Lena-Coppin/Le-Stylophuino/README.md

# Le-Variophuino
Un stylophone avec variation de fréquence...
...avec un soupçon de "frenchtouch"...
