Lena-Coppin/Le-Stylophuino/COPPIN_NOEL_G4_PeiP2_Arduino_projet_-_Variophuino.pptx

## Variophuino

Instrument de musique électronique basé sur le stylophone

COPPIN Léna NOEL Julien PeiP 2 G4

## Slide 2

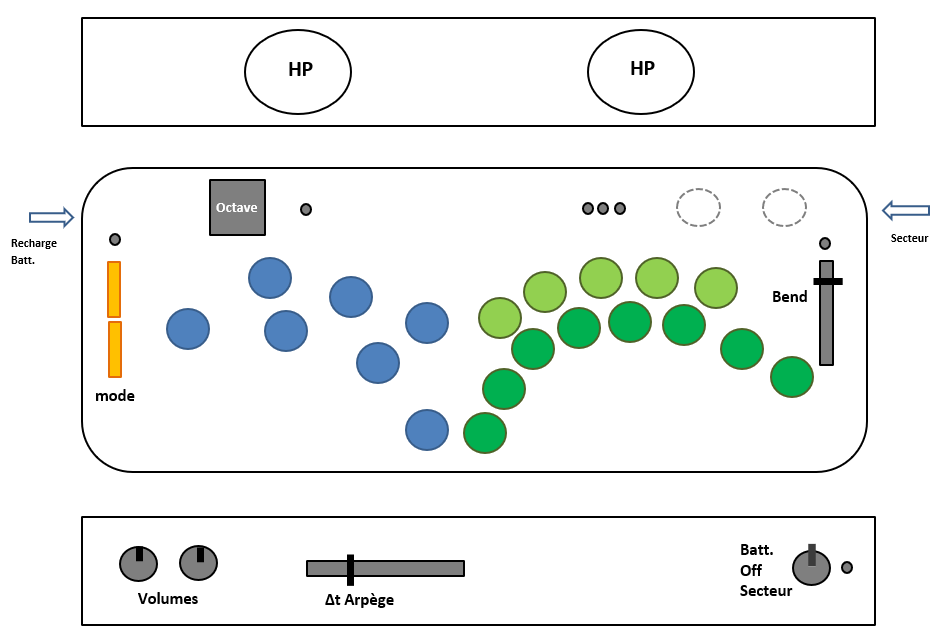
[picture p82: figure]

## Slide 3

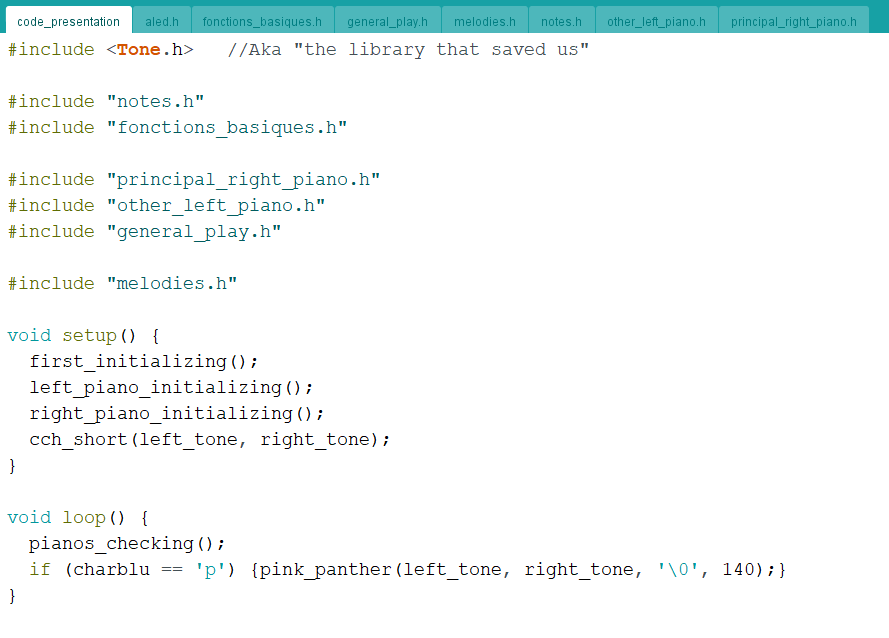
[picture p83: figure]

## Slide 4

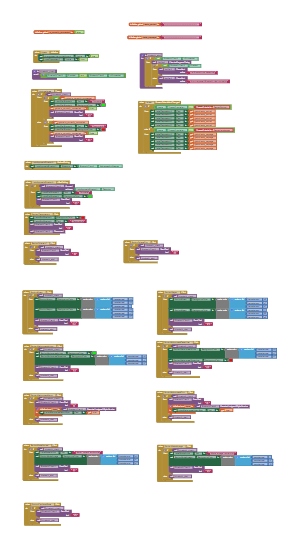
[picture p84: figure]
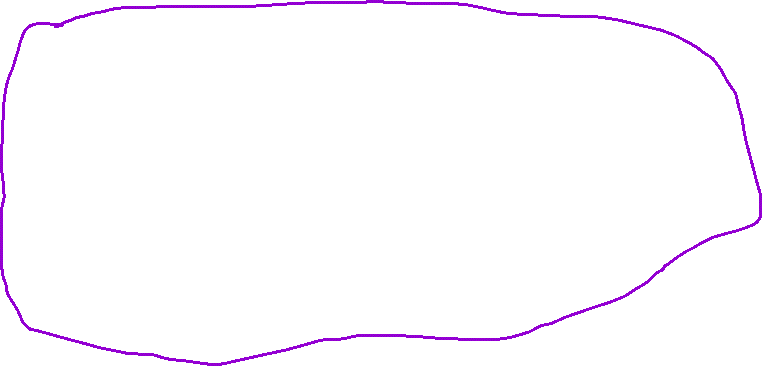
[picture p85: figure]
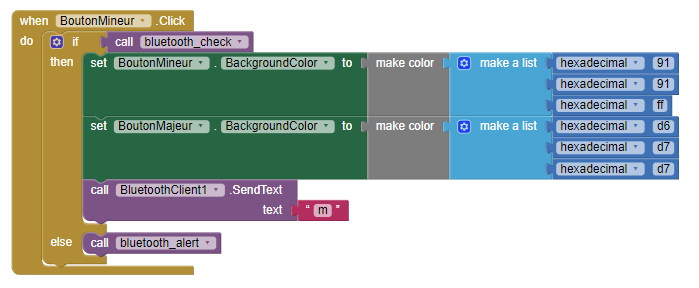
[picture p86: figure]

## Slide 5

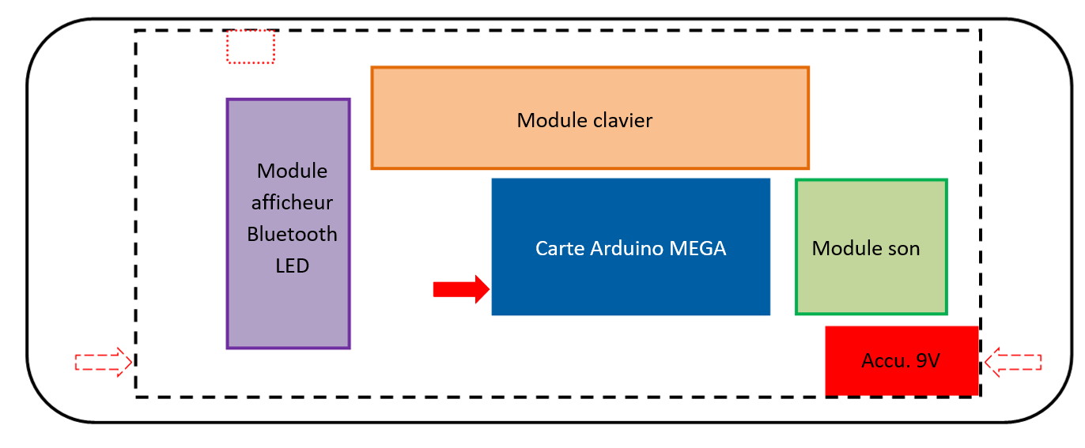
[picture p87: figure]

## Slide 6

Diagramme de Gantt final
