Lena-Coppin/Le-Stylophuino/Rapports de séances/Rapports Julien NOEL/Rapport de séance n°3 03-01-22.pdf

Julien NOEL | PeiP2 G4

Compte rendu séance 3 :

Il y a eu une grosse mise à jour du projet !

Tout d’abord voici la nouvelle organisation des fichiers :

code_fred_testons.ino est le fichier principal, où tous les fichiers .h seront importer (petite référence à Fred Testo pour le nom d’ailleurs, nom qui n’a pas d’importance car l’essentiel du code n’est pas dans ce fichier).

effets_bluetooth.h regroupera tous les effets que l’on pourra appliquer aux notes du piano principal droite.

En effet, maintenant le projet contient deux pianos indépendants (un « principal droite » et un autre « secondaire gauche ») avec un buzzer pour chaque. Par ailleurs, l’indépendance des deux buzzers a été un problème fort contraignant, problème réglé grâce à l’importation de la bibliothèque ToneLibrary.

Toutes les touches sont maintenant chacune reliées à une entrée numérique d’une carte Arduino MEGA.

Je pense que les noms des fichiers .h sont assez explicites par rapport à leur utilité principal, je ne détaillerai donc pas plus que les captures d’écran suivantes :

fonctions_basiques.h :

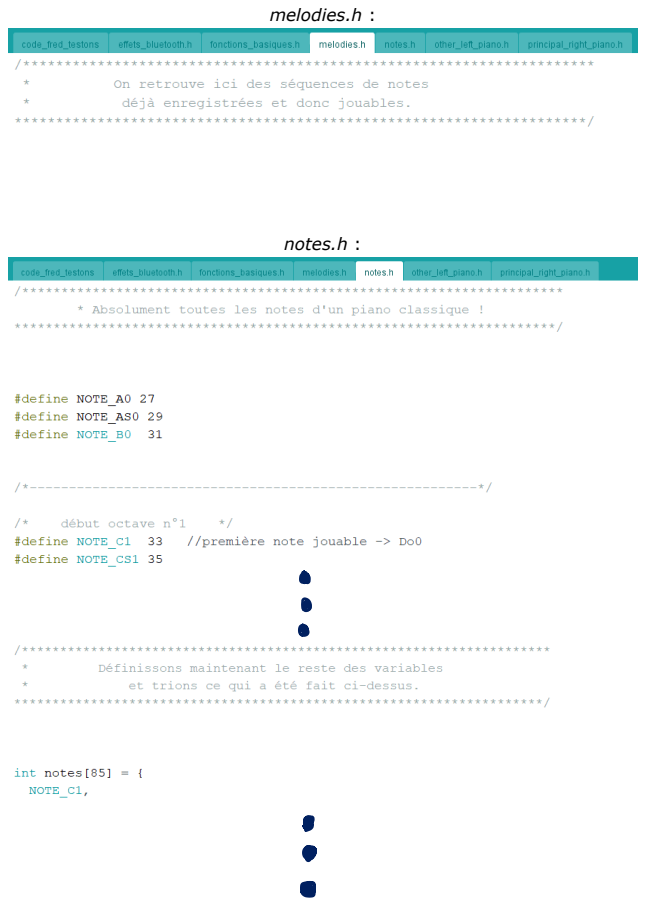
[picture p93: page 2]
melodies.h :; notes.h :

other_left_piano.h :

principal_right_piano.h :

Voici le code de code_fred_testons.ino au passage :

#include <Tone.h> //Aka "the library that saved us"

#include "notes.h"

#include "fonctions_basiques.h"

#include "principal_right_piano.h" #include "other_left_piano.h"

#include "melodies.h"

void setup() {
first_initializing();
left_piano_initializing(); right_piano_initializing(); cch_short(left_tone);
}

void loop() {
commands(Serial.read());
actual_frequencies_update(); left_piano_checking();
//right_piano_checking();
}

cch_short() est la fonction permettant de faire quelques sons quand la carte Arduino démarre.

left_piano_checking() et right_piano_checking() ne sont pas faites pour fonctionner simultanément, une fonction sera créée ultérieurement pour cela.

effets_bluetooth.h est importé dans fonctions_basiques.h (car pratique).
