Lena-Coppin/Le-Stylophuino/schemiano.pdf

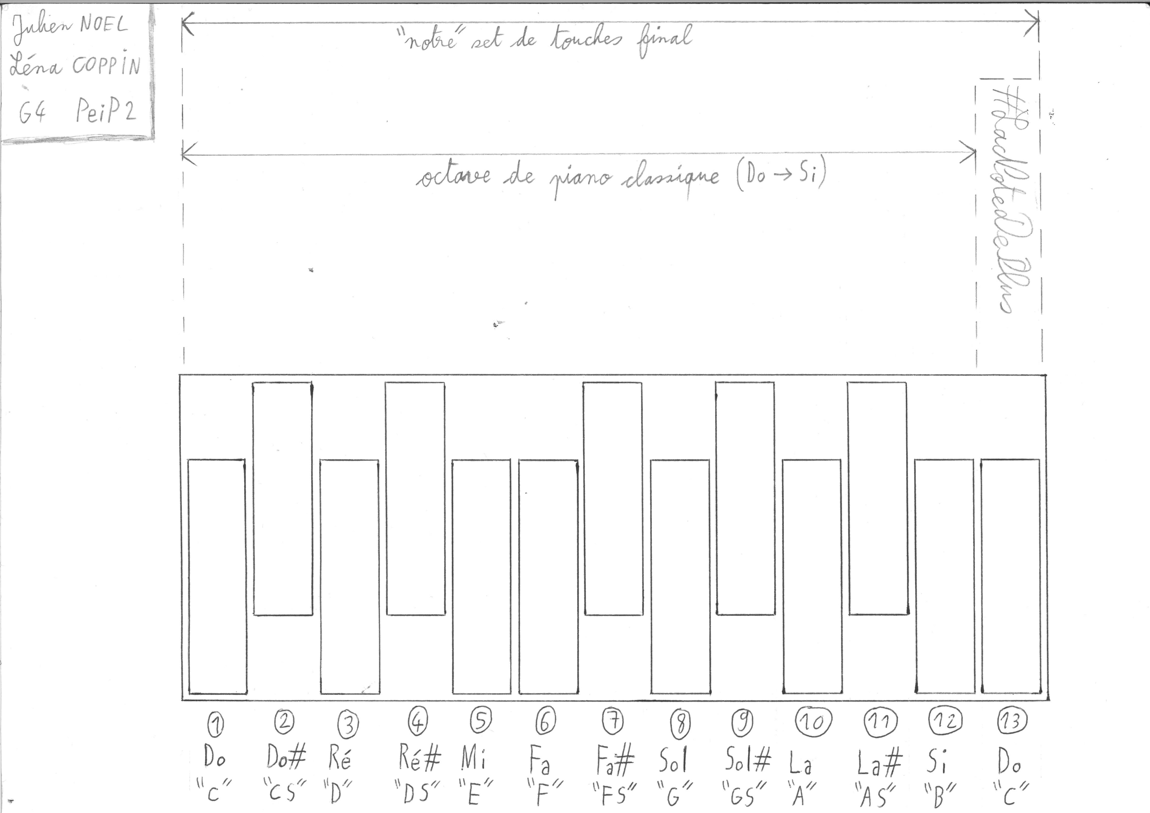
[picture p97: page 1]

yb- Noçt
f-û*" oo PP iN

t\ ,"t )"

erlr^* À* y* ttr-,"1'*

(r+ PeiP L

V
\
(1, -+ s;)

ç
fJ

gr'

@
Do#
"c s"

a
D,
//
C

5;
\\B//

5,1

,,
G,,

Ra
\t | trùr,

@@
R'#- Mi ttDs" "E"

@
5,1# La La#
"Gs" uA'
"As"

@
Ft

o
tr#
"F s'

Do

8

\\
F
/7 | t\
C

/7
