Lena-Coppin/Le-Stylophuino/Rapports de séances/Rapports Léna COPPIN/Programmes associés/piano_pot_2_notes_frequence_variation_2412_valide_8NOTES_OK_ALT.ino

//COPPIN Léna G4 PeiP2
//Programme permettant d'émettre un son avec un buzzer lors de l'appui d'une "touche" (appelée "bouton" ici) 
//Un potentiomètre lit et module la tension analogique envoyée aux I/O et en focntion de celle-ci on module la fréquence sortant du buzzer  = effet "pitchbend"
//Programme uniquement sur les notes naturelles, possibilité de jouer les notes altérées avec l'appuie d'un bouton (but_alt) 


//Déclaration des pins 
int but1 = 2;      //DO3
int but3 = 3;      //RE3
int but5 = 4;      //MI3
int but6 = 5;      //FA3
int but8 = 6;     //SOL3
int but10 = 7;    //LA3
int but12 = 8;     //SI3
int but13 = 9;     //DO4

int but_alt = 10;   //NOTE + 1/2 ton
//int but_oct = 11;  //NOTE A L'OCTAVE

int buzzer = 13;


//Initialisation des variables
const int pot = 0;
int bit_value = 0.0; //tension numérique
float real_tension = 0.0; //tension analogique

int f = 0; //fréquence 

void setup()
{
  //Déclarations des pins des "boutons" en INPUT
  pinMode(but1, INPUT);
  pinMode(but3, INPUT);
  pinMode(but5, INPUT);
  pinMode(but6, INPUT);
  pinMode(but8, INPUT);
  pinMode(but10, INPUT);
  pinMode(but12, INPUT);
  pinMode(but13, INPUT);
  
  pinMode(but_alt, INPUT);
  pinMode(but_oct, INPUT);

  //Déclarations des pins du buzzer en OUTPUT
  pinMode(buzzer, OUTPUT);

  //Communication voie série
  Serial.begin(9600);
}


void loop()
{
  //Lecture des valeurs des "boutons" (0 ou 1)
  int b1 = digitalRead(but1);
  int b3 = digitalRead(but3);
  int b5 = digitalRead(but5);
  int b6 = digitalRead(but6);
  int b8 = digitalRead(but8);
  int b10 = digitalRead(but10);
  int b12 = digitalRead(but12);
  int b13 = digitalRead(but13);
  
  int b_alt = digitalRead(but_alt);
  int b_oct = digitalRead(but_oct);
  
  
  //Lecture de la tension et affichage
  bit_value = analogRead(pot);
  real_tension = bit_value / 204.6;
  //Serial.print(real_tension);
  //Serial.print("  ");

//b_alt=1
if (b_alt == 1){
  //b1=1
  if( b1 == 1 ) {
    int f = 277;
  
    if(real_tension < 0.35){
      tone(buzzer, f);
      Serial.println("DO#3 : 277 Hz");
      }
  
    if((real_tension >= 0.35) && (real_tension < 0.8)){
      tone(buzzer, f+4);
      Serial.println("Modulation : 281 Hz");
      }
  
    if((real_tension >= 0.8) && (real_tension < 3)){
      tone(buzzer, f+8);
      Serial.println("Modulation : 285 Hz");
      }
        
    if((real_tension >= 3) && (real_tension < 4.8)){
      tone(buzzer, f+12);
      Serial.println("Modulation : 289 Hz");
      }
  
    if((real_tension >= 4.8) && (real_tension <= 5)){
      tone(buzzer, f+17);
      Serial.println("RE3 : 294 Hz");
      } 
    }





//b1=0
  if (b1==0) {
    
    //b3=0
    if (b3 == 0){
      
      //b5=0
      if (b5 == 0){
  
        //b6=0
        if (b6 == 0){
          
          //b8=0
          if (b8 == 0){
            
            //b10=0
            if (b10 == 0){
              
              //b12=0
              if (b12 == 0){
                
                //b13=0
                if (b13 == 0){
                  noTone(buzzer);
              }
                 //b13=1
                 if (b13 == 1){
                  
                  int f = 554;
                  
                  if(real_tension < 0.35){
                    tone(buzzer, f);
                    Serial.println("DO#4 : 554 Hz");
                    }
                
                  if((real_tension >= 0.35) && (real_tension < 0.8)){
                    tone(buzzer, f+8);
                    Serial.println("Modulation : 562 Hz");
                    }
                
                  if((real_tension >= 0.8) && (real_tension < 3)){
                    tone(buzzer, f+16);
                    Serial.println("Modulation : 570 Hz");
                    }
                      
                  if((real_tension >= 3) && (real_tension < 4.8)){
                    tone(buzzer, f+24);
                    Serial.println("Modulation : 578 Hz");
                    }
                
                  if((real_tension >= 4.8) && (real_tension <= 5)){
                    tone(buzzer, f+33);
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
          }
      
        if((real_tension >= 0.35) && (real_tension < 0.8)){
          tone(buzzer, f+5);
          Serial.println("Modulation : 354 Hz");
          }
      
        if((real_tension >= 0.8) && (real_tension < 3)){
          tone(buzzer, f+10);
          Serial.println("Modulation : 359 Hz");
          }
            
        if((real_tension >= 3) && (real_tension < 4.8)){
          tone(buzzer, f+15);
          Serial.println("Modulation : 364 Hz");
          }
      
        if((real_tension >= 4.8) && (real_tension <= 5)){
          tone(buzzer, f+21);
          Serial.println("FA#3 : 370 Hz");
          } 
       }
        
  //b3=1
  if ( b3 == 1 ){
    int f = 311;
  
    if(real_tension < 0.35){
      tone(buzzer, f);
      Serial.println("RE#3 : 311 Hz");
      }
  
    if((real_tension >= 0.35) && (real_tension < 0.8)){
      tone(buzzer, f+5);
      Serial.println("Modulation : 316 Hz");
      }
  
    if((real_tension >= 0.8) && (real_tension < 3)){
      tone(buzzer, f+10);
      Serial.println("Modulation : 321 Hz");
      }
        
    if((real_tension >= 3) && (real_tension < 4.8)){
      tone(buzzer, f+15);
      Serial.println("Modulation : 326 Hz");
      }
  
    if((real_tension >= 4.8) && (real_tension <= 5)){
      tone(buzzer, f+19);
      Serial.println("MI3 : 330 Hz");
      }
       }
  
}


//////////////////////////////////////////////////////////////////////////////////////////////////////////////////////////////////////////////////////////////////////////////////////////////////////////////////////////////////////


//b_alt=0
if(b_alt == 0){
  //b1=1
  if( b1 == 1 ) {
    int f = 262;
  
    if(real_tension < 0.35){
      tone(buzzer, f);
      Serial.println("DO3 : 262 Hz");
      }
  
    if((real_tension >= 0.35) && (real_tension < 0.8)){
      tone(buzzer, f+4);
      Serial.println("Modulation : 266 Hz");
      }
  
    if((real_tension >= 0.8) && (real_tension < 3)){
      tone(buzzer, f+7);
      Serial.println("Modulation : 269 Hz");
      }
        
    if((real_tension >= 3) && (real_tension < 4.8)){
      tone(buzzer, f+11);
      Serial.println("Modulation : 273 Hz");
      }
  
    if((real_tension >= 4.8) && (real_tension <= 5)){
      tone(buzzer, f+15);
      Serial.println("DO#3 : 277 Hz");
      } 
    }





//b1=0
  if (b1==0) {
    
    //b3=0
    if (b3 == 0){
      
      //b5=0
      if (b5 == 0){
  
        //b6=0
        if (b6 == 0){
          
          //b8=0
          if (b8 == 0){
            
            //b10=0
            if (b10 == 0){
              
              //b12=0
              if (b12 == 0){
                
                //b13=0
                if (b13 == 0){
                  noTone(buzzer);
              }
                 //b13=1
                 if (b13 == 1){
                  
                  int f = 523;
                  
                  if(real_tension < 0.35){
                    tone(buzzer, f);
                    Serial.println("DO4 : 523 Hz");
                    }
                
                  if((real_tension >= 0.35) && (real_tension < 0.8)){
                    tone(buzzer, f+8);
                    Serial.println("Modulation : 531 Hz");
                    }
                
                  if((real_tension >= 0.8) && (real_tension < 3)){
                    tone(buzzer, f+16);
                    Serial.println("Modulation : 539 Hz");
                    }
                      
                  if((real_tension >= 3) && (real_tension < 4.8)){
                    tone(buzzer, f+24);
                    Serial.println("Modulation : 547 Hz");
                    }
                
                  if((real_tension >= 4.8) && (real_tension <= 5)){
                    tone(buzzer, f+31);
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
          }
      
        if((real_tension >= 0.35) && (real_tension < 0.8)){
          tone(buzzer, f+5);
          Serial.println("Modulation : 335 Hz");
          }
      
        if((real_tension >= 0.8) && (real_tension < 3)){
          tone(buzzer, f+10);
          Serial.println("Modulation : 340 Hz");
          }
            
        if((real_tension >= 3) && (real_tension < 4.8)){
          tone(buzzer, f+15);
          Serial.println("Modulation : 345 Hz");
          }
      
        if((real_tension >= 4.8) && (real_tension <= 5)){
          tone(buzzer, f+19);
          Serial.println("FA3 : 349 Hz");
          } 
       }
        
  //b3=1
  if ( b3 == 1 ){
    int f = 294;
  
    if(real_tension < 0.35){
      tone(buzzer, f);
      Serial.println("RE3 : 294 Hz");
      }
  
    if((real_tension >= 0.35) && (real_tension < 0.8)){
      tone(buzzer, f+4);
      Serial.println("Modulation : 298 Hz");
      }
  
    if((real_tension >= 0.8) && (real_tension < 3)){
      tone(buzzer, f+8);
      Serial.println("Modulation : 302 Hz");
      }
        
    if((real_tension >= 3) && (real_tension < 4.8)){
      tone(buzzer, f+12);
      Serial.println("Modulation : 306 Hz");
      }
  
    if((real_tension >= 4.8) && (real_tension <= 5)){
      tone(buzzer, f+17);
      Serial.println("RE#3 : 311 Hz");
      }
       }
}

    }
