Lena-Coppin/Le-Stylophuino/LeCode/code_fred_testons/fonctions_basiques.h

/**********************************************************************************************
*     Voici toutes les fonctions qui permetteront le bon fonctionnement du variophuino.
*               Tous les effets non essentiels seront traités ailleurs.
**********************************************************************************************/




/*========================[PARTIE CALCULS]========================*/


double f_pitch(int n) {
  return 1.8125 * exp(0.058 * n);
};


void change_for_pitchbend(int n, int s) {
  /*s est compris entre 1 et 85 inclus.
  On garde les 8 premières valeurs de s
  possibles malgré l'inaudibilité.*/
  double gap = f_pitch(s);
  int new_gap = 0;
  
  bool c_1_semel = ((s==1)||(s==5)||(s==7)||(s==8)||(s==11)||(s==13)||(s==15)||(s==17));
  bool c_1_bis = ((s==18)||(s==20)||(s==22)||(s==24)||(s==25)||(s==27)||(s==29)||(s==31));
  bool c_1_ter = ((s==32)||(s==35)||(s==36)||(s==38)||(s==40)||(s==42)||(s==43)||(s==45));
  bool c_1_quater = ((s==47)||(s==50)||(s==51)||(s==52)||(s==54)||(s==56)||(s==59)||(s==60));
  bool c_1 = ((c_1_semel)||(c_1_bis)||(c_1_ter)||(c_1_quater));
  //La condition c_1 sera vraie si et seulement si on a besoin de ceil(gap).
  
  bool c_2 = ((s==72)||(s==73)||(s==78)||(s==79)||(s==80)||(s==82)||(s==83)||(s==84));
  //La condition c_2 sera vraie si et seulement si on a besoin de floor(gap - 1).

  if (c_1) {new_gap = ceil(gap);}   //(ceil(5.7) = 6; ceil(-6.9) = -6; ceil(1.0) = 1)
  else if (c_2) {new_gap = floor(gap - 1);}
  else if (s==85) {new_gap = NOTE_CS8 - NOTE_C8;}   //définition du 85ème écart nécessaire
  else {new_gap = floor(gap);}      //(floor(5.7) = 5; floor(-6.9) = -7; floor(1.0) = 1)

  if (mode == 1) {special_r_gaps[n] = new_gap;}
  else {
    pitchbend_variations_set[n] = new_gap;
    if (mode == 2) {perissando_gaps_live[n] = new_gap / 2;}
  }
};


void choosen_set(int i){
  /*L'entier i est compris entre 2 et 7 inclus.
  i ne vaut jamais 1 car sinon les premières notes
  de the_set[] seraient inaudibles.*/
  int index = 0;
  if (mode == 1) {
    if (i < 3) {current_set_number = 3;}
    else if (i > 6) {current_set_number = 6;}
    else {current_set_number = i;}
    for (int n = 0; n < 20; n++) {
      index = n + (current_set_number - 1) * 12;
      special_r_set[n] = notes[index];    //mise à jour de special_r_set[]
      change_for_pitchbend(n, index+1);   //mise à jour de special_r_gaps[]
    }
  }
  else {
    if (i < 2) {current_set_number = 2;}
    else if (i > 7) {current_set_number = 7;}
    else {current_set_number = i;}
    for (int n = 0; n < 13; n++){
      index = n + (current_set_number - 1) * 12;
      /*L'entier index est compris entre 12 et 84 inclus.
      Il parcourt 13 valeurs consécutives,
      en commençant et terminant par un multiple de 12.*/
      the_set[n] = notes[index];          //mise à jour de the_set[]
      change_for_pitchbend(n, index+1);   //mise à jour de pitchbend_variations_set[]
    }
  }
  write_matrix(HIGH, (char) 48+current_set_number);  //juste un peu d'ASCII...
};


void actual_frequencies_update() {
  an0 = analogRead(where_bend);
  analogWrite(where_led_bend, constrain(map(an0, 0, 1023, 255, -15), 0, 255));
  if (mode == 1) {
    for (int i = 0; i < 20; i++) {
      special_actual_r_frequencies[i] = special_r_set[i] + constrain(map(an0, 0, 1023, special_r_gaps[i], 0), 0, special_r_gaps[i]);
    }
  }
  else {
    for (int i = 0; i < 13; i++) {
      actual_frequencies[i] = the_set[i] + constrain(map(an0, 0, 1023, pitchbend_variations_set[i], 0), 0, pitchbend_variations_set[i]);
    }
  }
};


void actual_poten_speed() {
  an1 = constrain(map(analogRead(where_time), 50, 950, 1000, 12), 12, 1000);
  if (an1 <= 40) {diviseur = 4;}
  else {
    if (an1 <= 120) {diviseur = 8;}
    else {
      if (an1 <= 240) {diviseur = 12;}
      else {
        if (an1 <= 400) {diviseur = 16;}
        else {
          if (an1 <= 600) {diviseur = 20;}
          else {
            if (an1 <= 750) {diviseur = 25;}
            else {
              if (an1 <= 900) {diviseur = 30;}
              else {diviseur = 50;}
            }
          }
        }
      }
    }
  }
  delta_temps = an1 - (an1 % diviseur);
};


void set_plus() {
  int csn = current_set_number;
  csn = csn + 1;
  int csn_min, csn_max;
  if ((mode == 1) || (mode == 2)) {
    csn_min = 3;
    csn_max = 6;
  }
  else {
    csn_min = 2;
    csn_max = 7;
  }
  if (csn > csn_max) {csn = csn_min;}
  choosen_set(csn);
};


void set_moins() {
  int csn = current_set_number;
  csn = csn - 1;
  int csn_min, csn_max;
  if ((mode == 1) || (mode == 2)) {
    csn_min = 3;
    csn_max = 6;
  }
  else {
    csn_min = 2;
    csn_max = 7;
  }
  if (csn < csn_min) {csn = csn_max;}
  choosen_set(csn);
};


bool truth_and(bool H, bool L1=LOW, bool L2=LOW, bool L3=LOW, bool L4=LOW, bool L5=LOW, bool L6=LOW, bool L7=LOW, bool L8=LOW, bool L9=LOW, bool L10=LOW, bool L11=LOW, bool L12=LOW) {
  /*Le premier paramètre H est obligatoire.
  truth_and() peut accueillir jusqu'à
  13 paramètres, tous de type bool.
  L'ordre des paramètres est extrêmement
  important, surtout par rapport au premier.*/
  return (!L1 && !L2 && !L3 && !L4 && !L5 && !L6 && !L7 && !L8 && !L9 && !L10 && !L11 && !L12) && H;
};


void change_metrovalle(char c) {
  float mtv = 60000 / metrovalle;
  if (c == 'i') {mtv -= 15;}
  else if (c == 'I') {mtv += 15;}
  if (mtv < 45) {mtv = 210;}
  else if (mtv > 210) {mtv = 45;}
  metrovalle = (unsigned int) 60000 / mtv;
  led_tempo_state = HIGH;
  digitalWrite(where_led_tempo, led_tempo_state);
  current_time = millis();
  last_time = current_time;
};


void checking_tempo() {
  if (metronome) {
    current_time = millis();
    if (current_time - last_time >= metrovalle) {
      led_tempo_state = !led_tempo_state;
      digitalWrite(where_led_tempo, led_tempo_state);
      last_time = current_time;
    }
  }
};


void first_initializing() {
  Serial.begin(9600);
  Serial1.begin(9600);
  pinMode(where_led_on_off, OUTPUT);
  pinMode(where_led_B_b, OUTPUT);
  pinMode(where_led_G_b, OUTPUT);
  pinMode(where_led_R_b, OUTPUT);
  pinMode(where_led_B_m, OUTPUT);
  pinMode(where_led_G_m, OUTPUT);
  pinMode(where_led_R_m, OUTPUT);
  pinMode(where_led_bend, OUTPUT);
  pinMode(where_led_tempo, OUTPUT);
  pinMode(where_led_recorded, OUTPUT);
  pinMode(where_led_for_bluetooth, OUTPUT);
  pinMode(CS_pin, OUTPUT);
  pinMode(DIN_pin, OUTPUT);
  pinMode(CLK_pin, OUTPUT);
  digitalWrite(where_led_on_off, HIGH);
  led_b_shine(0, 0, 0);
  led_m_shine(bleu_lavande[0], bleu_lavande[1], bleu_lavande[2]);
  digitalWrite(where_led_bend, LOW);
  digitalWrite(where_led_tempo, LOW);
  digitalWrite(where_led_recorded, LOW);
  digitalWrite(where_led_for_bluetooth, LOW);
  screenitialisation();
  choosen_set(4);
  actual_frequencies_update();
  actual_poten_speed();
};


void combien_de_temps(bool a) {
  if (a) {current_time = millis();}
  else {Serial.println(millis() - current_time);}
}


void buzzer_test(Tone a, int note, int t=100) {
  //tone(buzzer, note, t);
  a.play(note, t);
  /*Il faut D'ABORD initialiser le buzzer !!*/
};



/*================================================================*/



/*=======================[PARTIE AFFICHAGE]=======================*/


void print_note(int i) {
  /*i est compris entre 0 et 84 car
  c'est l'indice de la note de la liste notes[].
  Cela permet malgré tout d'afficher les 8
  premières notes (quand 0 <= i <= 7).*/
  char lettre_note;
  char diese_note;
  char numero_note;
  int i_bis = (i+1) % 12;             
  //i_bis est compris entre 0 et 11 inclus
  int i_ter = floor(i / 12) + 1;
  //i_ter est compris entre 1 et 8 inclus

  switch (i_bis) {
    case 1:
      lettre_note = 'C';    //"C"
      break;
    case 2:
      lettre_note = 'C';    //"CS"
      break;
    case 3:
      lettre_note = 'D';    //"D"
      break;
    case 4:
      lettre_note = 'D';    //"DS"
      break;
    case 5:
      lettre_note = 'E';    //"E"
      break;
    case 6:
      lettre_note = 'F';    //"F"
      break;
    case 7:
      lettre_note = 'F';    //"FS"
      break;
    case 8:
      lettre_note = 'G';    //"G"
      break;
    case 9:
      lettre_note = 'G';    //"GS"
      break;
    case 10:
      lettre_note = 'A';    //"A"
      break;
    case 11:
      lettre_note = 'A';    //"AS"
      break;
    case 0:
      lettre_note = 'B';    //"B"
      break;
    }

  if ((i_bis==2)||(i_bis==4)||(i_bis==7)||(i_bis==9)||(i_bis==11)) {
    diese_note = 'S';}
  else {diese_note = '\0';}
  //'\0' -> caractère nul

  numero_note = (char) (48+i_ter);
  /*En code ASCII, le numéro  du caractère '0' est 48.
  Les caractères suivent le même ordre que les chiffres.
  Donc le numéro du caractère '3' en ASCII est 48+3=51 par exemple.*/
  
  Serial.print(lettre_note);
  Serial.print(diese_note);
  Serial.print(numero_note);
};


void print_current_set() {
  int index = 0;
  Serial.print("Device currently adjusted to the \"set\" number ");
  Serial.print(current_set_number);
  Serial.println(" :");
  for (int n = 0; n < 13; n++){
    index = n + (current_set_number - 1) * 12;
    Serial.print("  ");
    print_note(index);
    if (n == 12) {Serial.println("\n");}
    else {Serial.print("\t;");}
    }
};


void print_variation_set() {
  Serial.print("Associated variations :   [ ");
  for (int i = 0; i < 13; i++){
    Serial.print(pitchbend_variations_set[i]);
    if (i == 12) {Serial.println(" ]\n");}
    else {Serial.print(" ; ");}
  }
};


void print_truth(bool a) {
  if (a) {Serial.println("True");}
  else {Serial.println("False");}
};


void print_byte(byte b) {
  for (int i=7; i >= 0; i--) {
    Serial.print(bitRead(b, i));
    if (i == 0) {Serial.println();}
  }
}


void print_minmaj(bool a, bool b) {
  if (a) {Serial.print("mineur");}
  else if (b) {Serial.print("majeur");}
};


//ça ne sert qu'au test, la liste se change manuellement
void print_list() {
  int l = 20;
  Serial.print("[ ");
  for (int i = 0; i < l; i++){
    Serial.print(special_actual_r_frequencies[i]);
    if (i == l-1) {Serial.println(" ]\n");}
    else {Serial.print(" ; ");}
  }
};


/*================================================================*/



/*=======================[PARTIE COMMANDES]=======================*/


void commands() {
  if (Serial.available() || Serial1.available()) {
    int ancien_mode = mode;
    unsigned int bpm;
    if (Serial1.available()) {charblu = Serial1.read();}
    else if (Serial.available()) {charblu = Serial.read();}
    switch (charblu) {
      case 'S':
        print_current_set();
        break;
      case 'V':
        print_variation_set();
        break;
      case '+':
        set_plus();
        break;
      case '-':
        set_moins();
        break;
      case 'm':
        minl = HIGH;
        majl = LOW;
        led_m_shine(bleu_lavande[0], bleu_lavande[1], bleu_lavande[2]);
        break;
      case 'M':
        minl = LOW;
        majl = HIGH;
        led_m_shine(rose_bonbon[0], rose_bonbon[1], rose_bonbon[2]); 
        break;
      case 'A':
        metronome = HIGH;
        led_tempo_state = HIGH;
        digitalWrite(where_led_tempo, led_tempo_state);
        current_time = millis();
        last_time = current_time;
        break;
      case 'D':
        metronome = LOW;
        led_tempo_state = LOW;
        digitalWrite(where_led_tempo, led_tempo_state);
        current_time = millis();
        last_time = current_time;
        break;
      case 'i':
        change_metrovalle('i');
        bpm = floor(60000/metrovalle);
        Serial1.write(bpm);
        break;
      case 'I':
        change_metrovalle('I');
        bpm = floor(60000/metrovalle);
        Serial1.write(bpm);
        break;
      case 't':
        write_matrix(HIGH, '\0', (tournement_total+1)%4);
        break;
      case 'N':
        digitalWrite(where_led_for_bluetooth, HIGH);
        break;
      case 'F':
        digitalWrite(where_led_for_bluetooth, LOW);
        break;
      case '0':
        if (ancien_mode != 0) {mode_is_changing = HIGH;}
        mode = 0;
        led_b_shine(0, 0, 0);
        choosen_set(4);
        break;
      case '1':
        if (ancien_mode != 1) {mode_is_changing = HIGH;}
        mode = 1;
        led_b_shine(golden[0], golden[1], golden[2]);
        choosen_set(4);
        break;
      case '2':
        if (ancien_mode != 2) {mode_is_changing = HIGH;}
        mode = 2;
        led_b_shine(tomato[0], tomato[1], tomato[2]);
        choosen_set(4);
        break;
    }
  }
  checking_tempo();
  /*
  if (minl) {Serial.println("Mineur\n");}
  else if (majl) {Serial.println("Majeur\n");}
  */
};


/*================================================================*/
